AntoineAndre/uta_kb/firmware/uta_qmk/keymaps/default/readme.md

# The default uta keymap

The default uta keymap
