AntoineAndre/uta_kb/(commit log)

2021-04-10 Update readme with wiring and software
    Add more precisions to the wiring and programming parts.
    Add the top front visual render with embbed function keys
2021-04-11 Add wiring schema and final picture to readme
    Update readme with the electric schema for the wiring
    Add the final result picture
2021-04-11 Fix wiring schema illustration
2021-04-11 Add arduino script
    Add the Arduino script for uta keyboard with comments
    Add more details in the readme
    Change the name of the pictures (from 'final' to 'result')
